sethkaz/SuperPower-GPLv3/README.md

# Super Power RPi Project

This repo was created to make a copy of the SuperPower-RPi project under the license GPLv3.

Please refer to the main Repo (https://github.com/SensorsIot/SuperPower) for the latest version.
