sethkaz/SuperPower-GPLv3/SuperPower-RPi-KiCAD/SuperPower-RPi-KiCAD.kicad_pcb

## KiCad design SuperPower-RPi-KiCAD/SuperPower-RPi-KiCAD.kicad_pcb (2021-02-07)

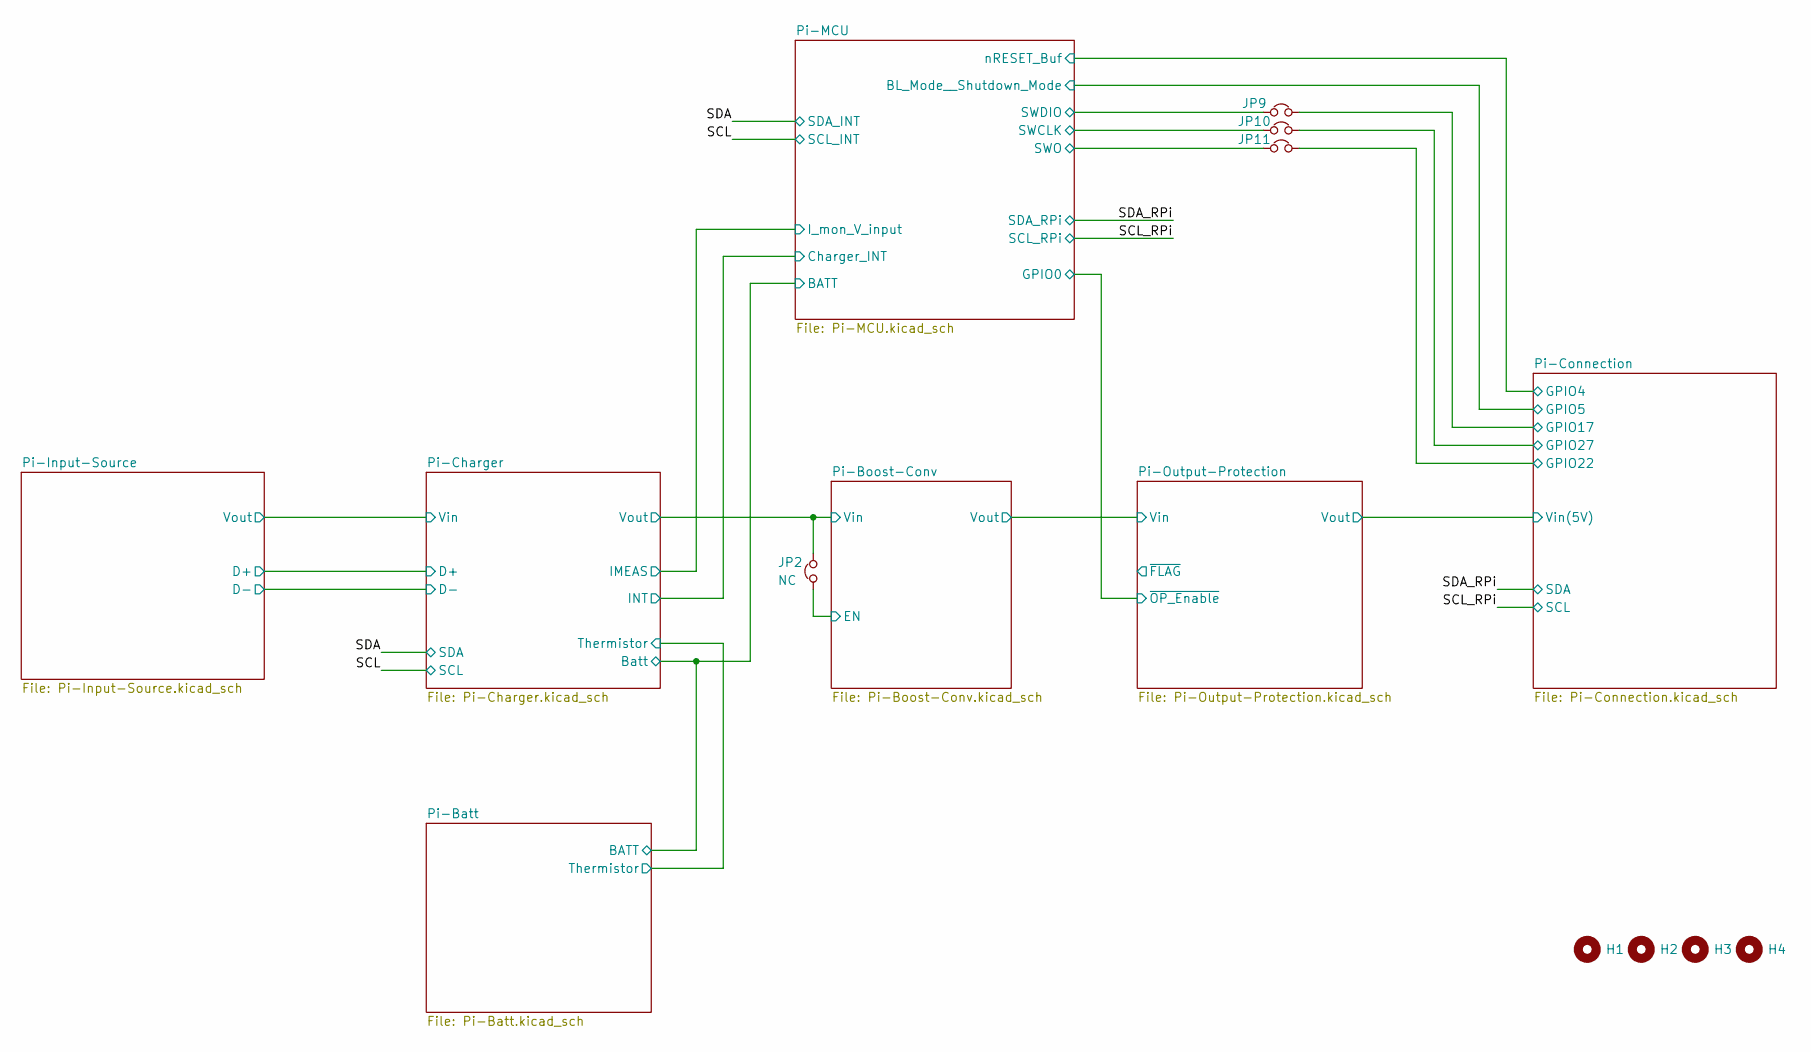
[picture p1: schematic SuperPower-RPi-KiCAD.kicad_sch, SuperPower-Leto]

Parts:
H1, H2, H3, H4: DNP; MountingHole_2.7mm_M2.5_ISO14580_Pad_TopBottom
JP2: NC; SolderJumper-2_P1.3mm_Bridged_Pad1.0x1.5mm
JP9, JP10, JP11: Jumper_NC_Small; SolderJumper-2_P1.3mm_Bridged_Pad1.0x1.5mm

Connections:
/Pi-Boost-Conv/EN: JP2.1; also elsewhere on the board
/Pi-Boost-Conv/Vin: JP2.2; also elsewhere on the board
/Pi-Connection/GPIO17: JP9.2; also elsewhere on the board
/Pi-Connection/GPIO22: JP11.2; also elsewhere on the board
/Pi-Connection/GPIO27: JP10.2; also elsewhere on the board
/Pi-MCU/SWCLK: JP10.1; also elsewhere on the board
/Pi-MCU/SWDIO: JP9.1; also elsewhere on the board
/Pi-MCU/SWO: JP11.1; also elsewhere on the board

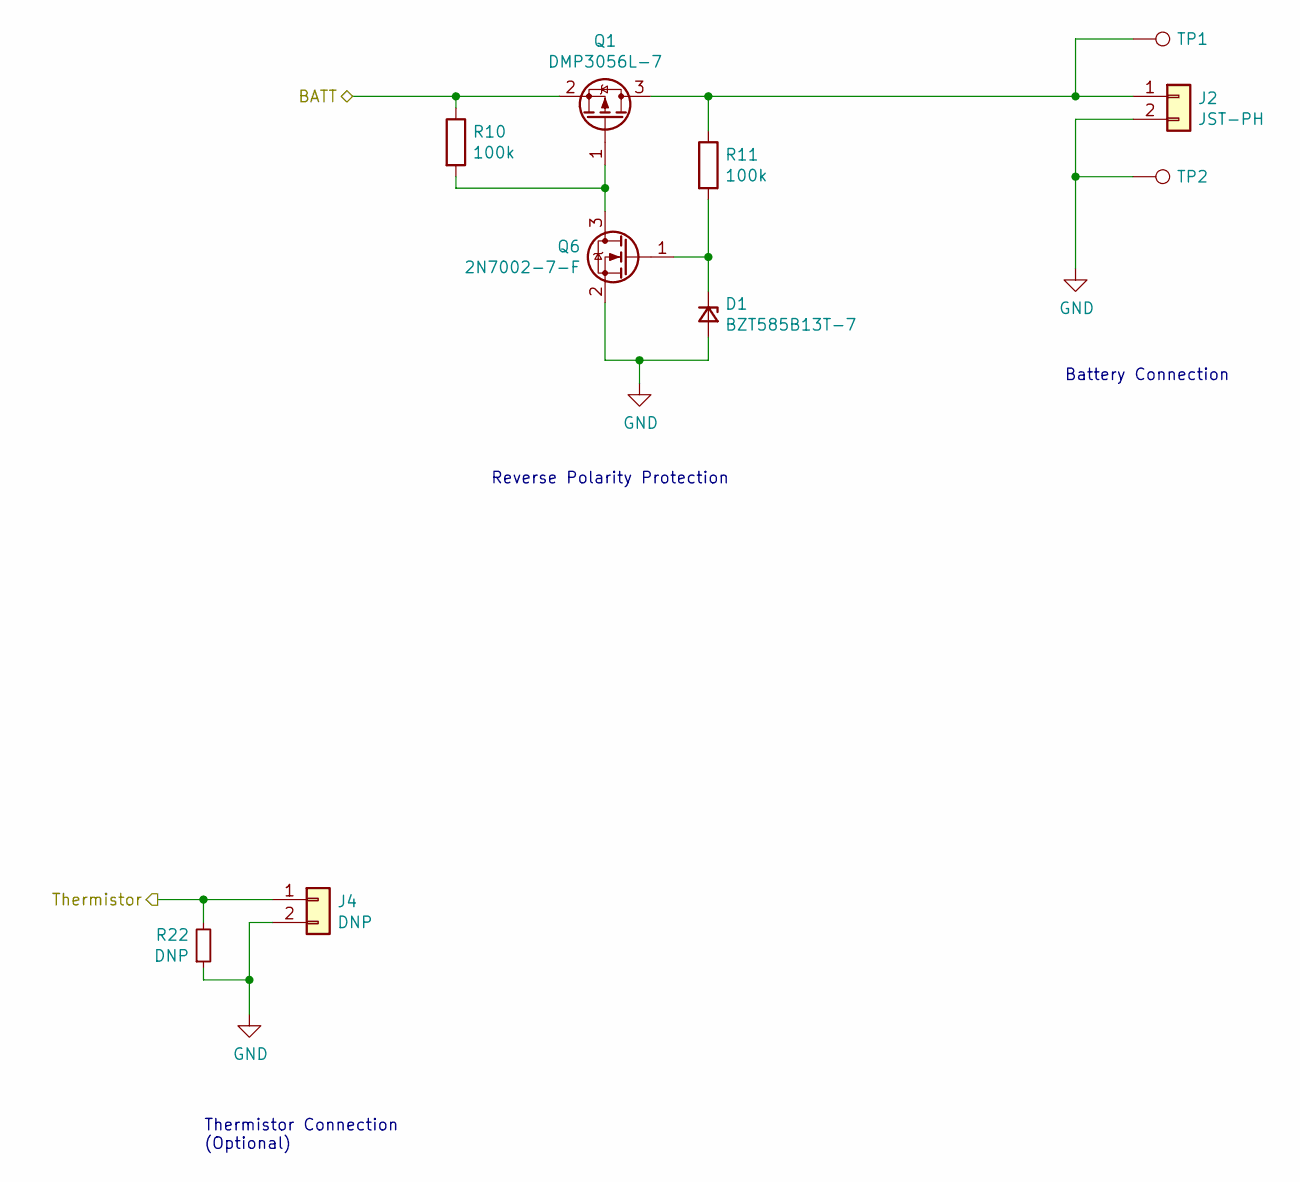
[picture p2: schematic Pi-Batt.kicad_sch, SuperPower-Leto]

Parts:
D1: BZT585B13T-7; D_SOD-523; Mfg PN BZT585B13T-7; Digi-Key PN BZT585B13T-7DICT-ND
J2: JST-PH; JST_PH_S2B-PH-K_1x02_P2.00mm_Horizontal; Mfg PN S2B-PH-K-S(LF)(SN)
J4: DNP; PinHeader_1x02_P2.00mm_Vertical; Mfg PN DNP
Q1: Q_PMOS_DMP3056L-7_SOT-23; SOT-23; Mfg PN DMP3056L-7; Digi-Key PN DMP3056L-7DICT-ND
Q6: 2N7002-7-F; SOT-23; Mfg PN 2N7002-7-F; Digi-Key PN 2N7002-FDICT-ND
R10, R11: 100k; R_0402_1005Metric; Mfg PN RC0402FR-07100KL; Digi-Key PN 311-100KLRCT-ND
R22: DNP; R_0603_1608Metric
TP1, TP2: DNP; SolderWire-1.5sqmm_1x01_D1.7mm_OD3.9mm

Connections:
/Pi-Batt/BATT: Q1.2 (S), R10.1; also elsewhere on the board
/Pi-Batt/Thermistor: J4.1, R22.2; also elsewhere on the board
GND: D1.2 (A), J2.2, J4.2, Q6.2 (S), R22.1, TP2.1; also elsewhere on the board
unnamed: D1.1 (K), Q6.1 (G), R11.2
unnamed: J2.1, Q1.3 (D), R11.1, TP1.1
unnamed: Q1.1 (G), Q6.3 (D), R10.2

Notes on the sheet:
Thermistor Connection (Optional)
Reverse Polarity Protection
Battery Connection

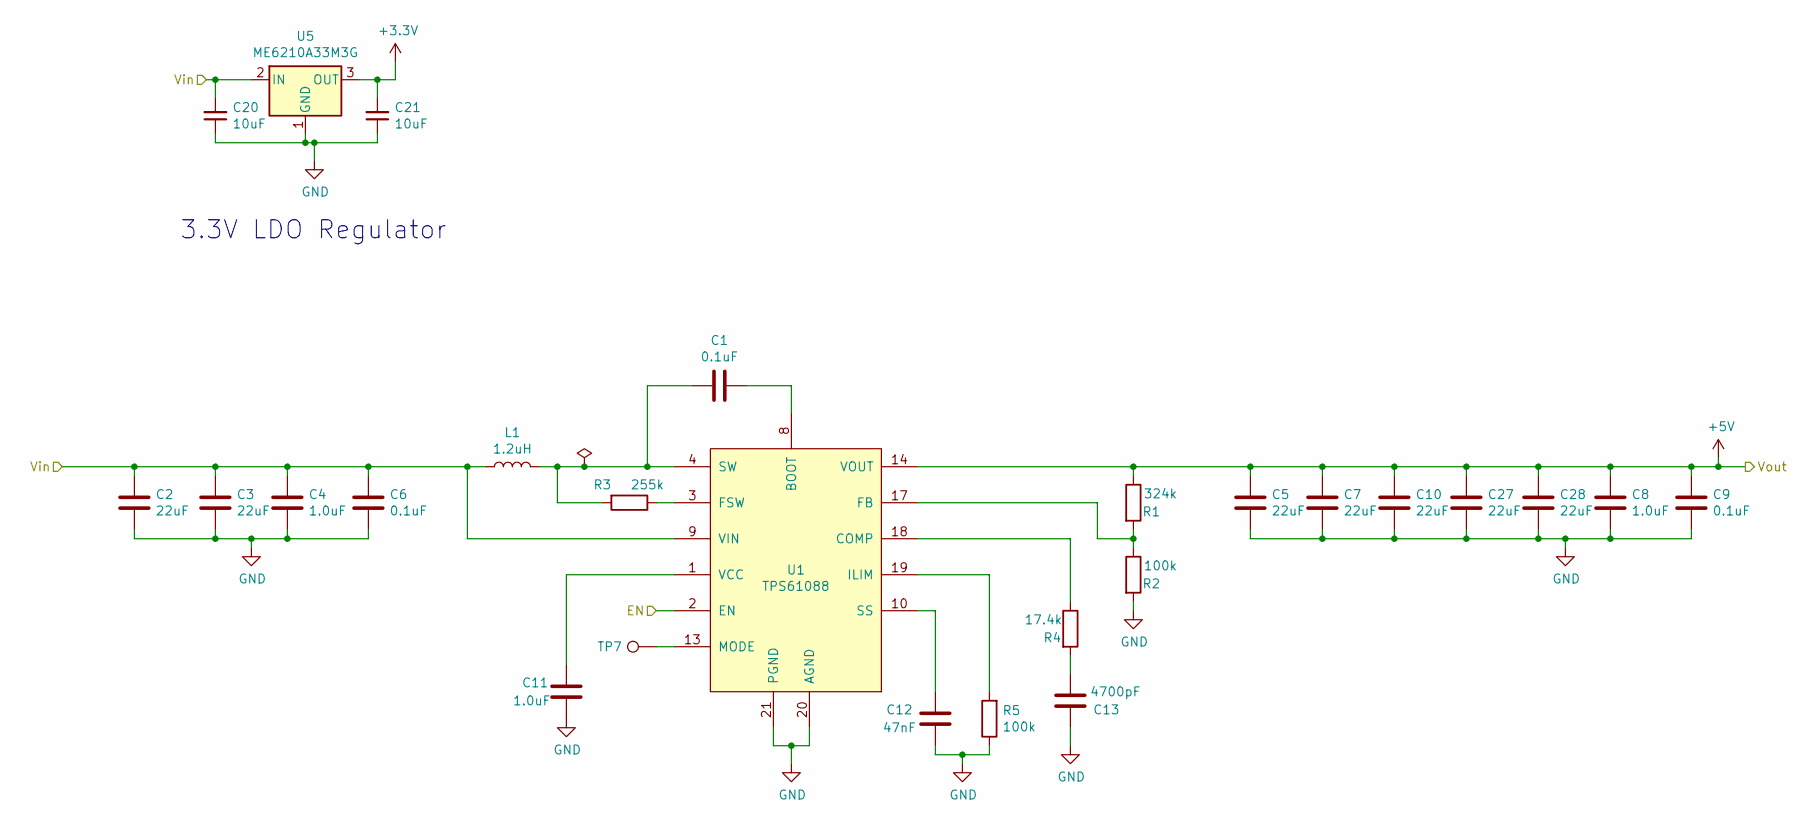
[picture p3: schematic Pi-Boost-Conv.kicad_sch, SuperPower-Leto]

Parts:
C1, C6, C9: 0.1uF; C_0402_1005Metric; Mfg PN TMK105BJ104KV-F; Digi-Key PN 587-1456-1-ND
C2, C3, C5, C7, C10, C27, C28: 22uF; C_1206_3216Metric; Mfg PN CL31A226KAHNNNE; Digi-Key PN 1276-3047-1-ND
C4, C8, C11: 1.0uF; C_0402_1005Metric; Mfg PN GRM155R61E105KA12D; Digi-Key PN 490-10017-1-ND
C12: 47nF; C_0402_1005Metric; Mfg PN GRM155R71E473KA88D; Digi-Key PN 490-3254-1-ND
C13: 4700pF; C_0402_1005Metric; Mfg PN CC0402KRX7R8BB472; Digi-Key PN 311-1039-1-ND
C20, C21: 10uF; C_0805_2012Metric; Mfg PN GRM21BR61E106KA73L; Digi-Key PN 490-5523-1-ND
L1: 1.2uH; L_Sumida_CDMC8D28_9.5x8.7mm; Mfg PN CDMC8D28NP-1R2MC; Digi-Key PN 308-1618-1-ND
R1: 324k; R_0402_1005Metric; Mfg PN ERJ-2RKF3243X; Digi-Key PN P324KLCT-ND
R2: 100k; R_0402_1005Metric; Mfg PN RC0402FR-07100KL; Digi-Key PN 311-100KLRCT-ND
R3: 255k; R_0603_1608Metric; Mfg PN RC0603FR-07255KL; Digi-Key PN 311-255KHRCT-ND
R4: 17.4k; R_0402_1005Metric; Mfg PN RC0402FR-0717K4L; Digi-Key PN 311-17.4KLRCT-ND
R5: 100k; R_0603_1608Metric; Mfg PN RC0603FR-07100KL; Digi-Key PN 311-100KHRCT-ND
TP7: DNP; TestPoint_Pad_1.0x1.0mm
U1: TPS61088; TI_VQFN_3.5x4.5mm; Mfg PN TPS61088RHLR; Digi-Key PN 296-43620-1-ND
U5: ME6210A33M3G; SOT-23; Mfg PN ME6210A33M3G

Connections:
+3V3: C21.2, U5.3 (OUT); also elsewhere on the board
+5V: C5.1, C7.1, C8.1, C9.1, C10.1, C27.1, C28.1, R1.1, U1.14 (VOUT), U1.15 (VOUT), U1.16 (VOUT); also elsewhere on the board
/Pi-Boost-Conv/EN: U1.2 (EN); also elsewhere on the board
/Pi-Boost-Conv/Vin: C2.1, C3.1, C4.1, C6.1, C20.2, L1.1, U1.9 (VIN), U5.2 (IN); also elsewhere on the board
GND: C2.2, C3.2, C4.2, C5.2, C6.2, C7.2, C8.2, C9.2, C10.2, C11.2, C12.1, C13.2, C20.1, C21.1, C27.2, C28.2, R2.2, R5.1, U1.11 (NC), U1.12 (NC), U1.20 (AGND), U1.21 (PGND), U5.1 (GND); also elsewhere on the board
unnamed: C1.1, U1.8 (BOOT)
unnamed: C1.2, L1.2, R3.2, U1.4 (SW), U1.5 (SW), U1.6 (SW), U1.7 (SW)
unnamed: C11.1, U1.1 (VCC)
unnamed: C12.2, U1.10 (SS)
unnamed: C13.1, R4.2
unnamed: R1.2, R2.1, U1.17 (FB)
unnamed: R3.1, U1.3 (FSW)
unnamed: R4.1, U1.18 (COMP)
unnamed: R5.2, U1.19 (ILIM)
unnamed: TP7.1, U1.13 (MODE)

Notes on the sheet:
3.3V LDO Regulator

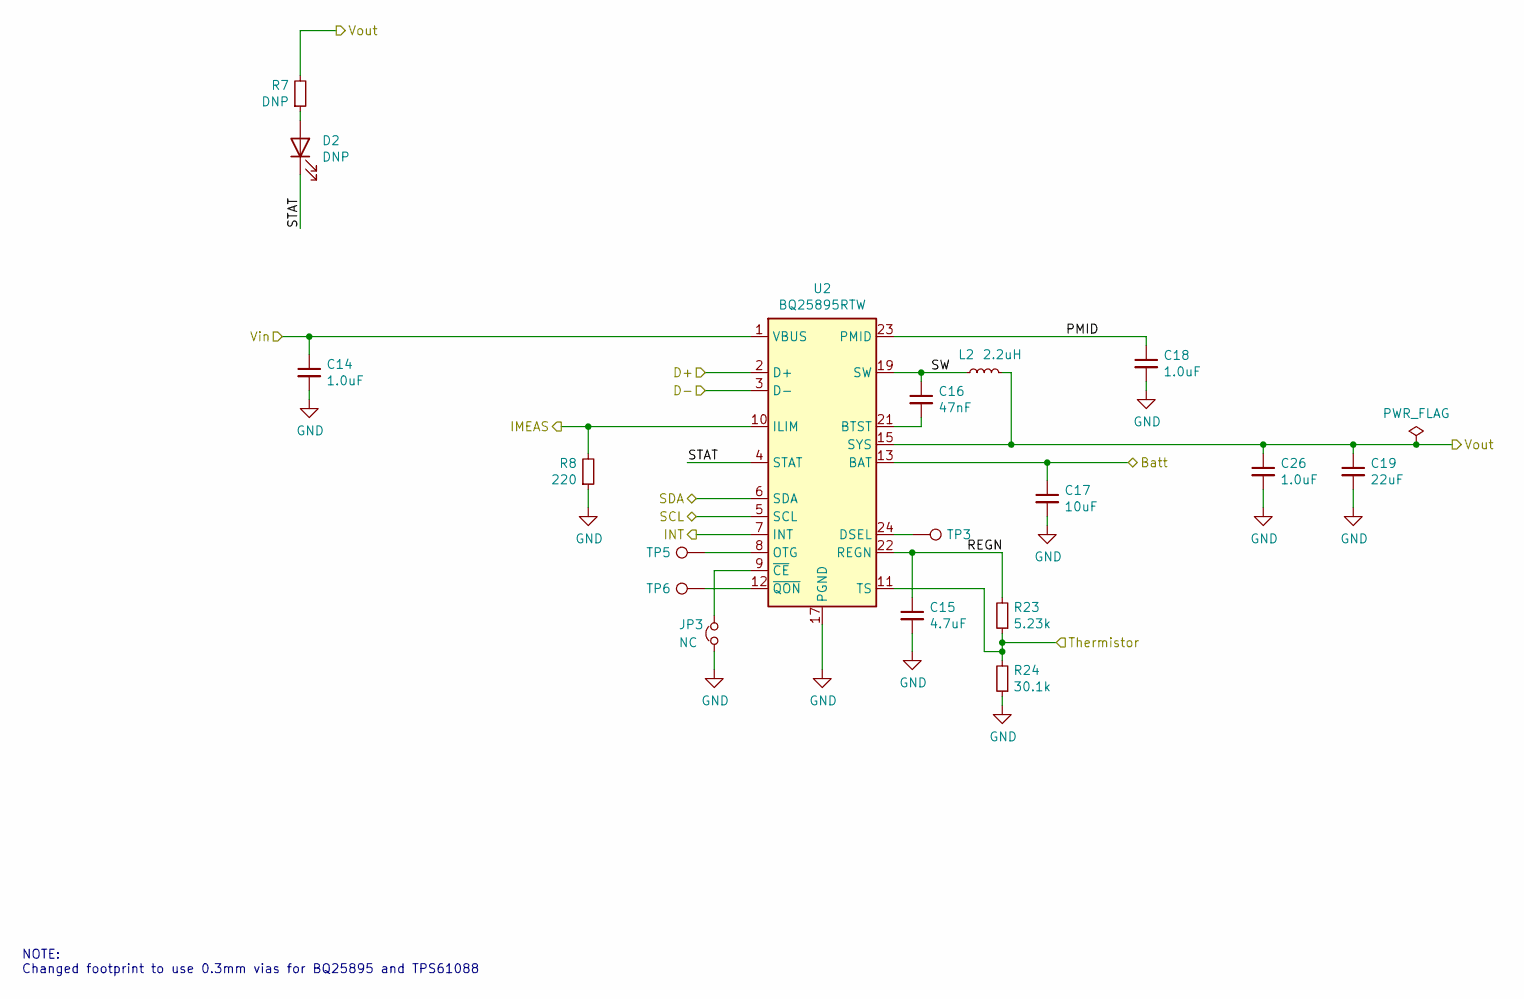
[picture p4: schematic Pi-Charger.kicad_sch, SuperPower-Leto]

Parts:
C14, C18, C26: 1.0uF; C_0402_1005Metric; Mfg PN GRM155R61E105KA12D; Digi-Key PN 490-10017-1-ND
C15: 4.7uF; C_0603_1608Metric; Mfg PN CL10A475KA8NQNC; Digi-Key PN 1276-1900-1-ND
C16: 47nF; C_0402_1005Metric; Mfg PN GRM155R71E473KA88D; Digi-Key PN 490-3254-1-ND
C17: 10uF; C_0805_2012Metric; Mfg PN GRM21BR61E106KA73L; Digi-Key PN 490-5523-1-ND
C19: 22uF; C_1206_3216Metric; Mfg PN CL31A226KAHNNNE; Digi-Key PN 1276-3047-1-ND
D2: DNP; LED_0603_1608Metric
JP3: NC; SolderJumper-2_P1.3mm_Bridged_Pad1.0x1.5mm
L2: 2.2uH; L_Vishay_IHLP-2525; Mfg PN IHLP2525CZER2R2M01; Digi-Key PN 541-1008-1-ND
R7: DNP; R_0603_1608Metric
R8: 220; R_0603_1608Metric; Mfg PN RC0603FR-07220RL; Digi-Key PN 311-220HRCT-ND
R23: 5.23k; R_0603_1608Metric; Mfg PN RC0603FR-075K23L; Digi-Key PN 311-5.23KHRCT-ND
R24: 30.1k; R_0603_1608Metric; Mfg PN RC0603FR-0730K1L; Digi-Key PN 311-30.1KHRCT-ND
TP3, TP5, TP6: DNP; TestPoint_Pad_1.0x1.0mm
U2: BQ25895RTW; Texas_S-PWQFN-N24_EP2.7x2.7mm_ThermalVias; Mfg PN BQ25895RTWR; Digi-Key PN 296-44345-1-ND

Connections:
/Pi-Batt/BATT: C17.1, U2.13 (BAT), U2.14 (BAT); also elsewhere on the board
/Pi-Batt/Thermistor: R23.1, R24.2, U2.11 (TS); also elsewhere on the board
/Pi-Boost-Conv/Vin: C19.1, C26.1, L2.2, R7.2, U2.15 (SYS), U2.16 (SYS); also elsewhere on the board
/Pi-Charger/D+: U2.2 (D+); also elsewhere on the board
/Pi-Charger/D-: U2.3 (D-); also elsewhere on the board
/Pi-Charger/IMEAS: R8.2, U2.10 (ILIM); also elsewhere on the board
/Pi-Charger/PMID: C18.1, U2.23 (PMID)
/Pi-Charger/REGN: C15.1, R23.2, U2.22 (REGN)
/Pi-Charger/STAT: D2.1 (K), U2.4 (STAT)
/Pi-Charger/SW: C16.1, L2.1, U2.19 (SW), U2.20 (SW)
/Pi-Charger/Vin: C14.1, U2.1 (VBUS); also elsewhere on the board
/Pi-MCU/Charger_INT: U2.7 (INT); also elsewhere on the board
/SCL: U2.5 (SCL); also elsewhere on the board
/SDA: U2.6 (SDA); also elsewhere on the board
GND: C14.2, C15.2, C17.2, C18.2, C19.2, C26.2, JP3.1, R8.1, R24.1, U2.17 (PGND), U2.18 (PGND), U2.25 (PGND); also elsewhere on the board
unnamed: C16.2, U2.21 (BTST)
unnamed: D2.2 (A), R7.1
unnamed: JP3.2, U2.9 (~CE)
unnamed: TP3.1, U2.24 (DSEL)
unnamed: TP5.1, U2.8 (OTG)
unnamed: TP6.1, U2.12 (~QON)

Notes on the sheet:
NOTE: Changed footprint to use 0.3mm vias for BQ25895 and TPS61088

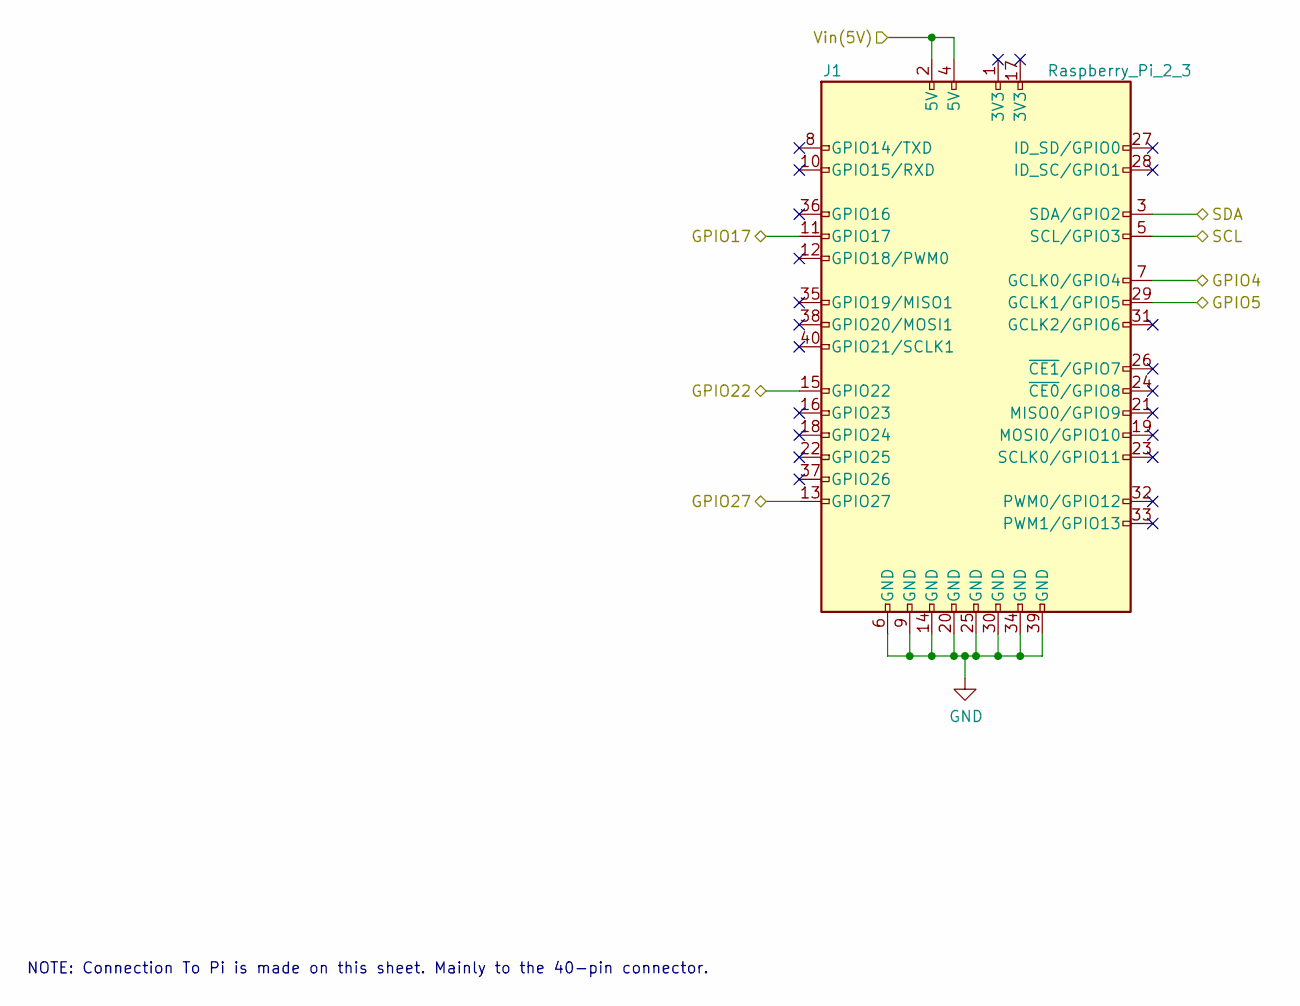
[picture p5: schematic Pi-Connection.kicad_sch, SuperPower-Leto]

Parts:
J1: Raspberry_Pi_2_3; PinSocket_2x20_P2.54mm_Vertical_With_Pogo

Connections:
/Pi-Connection/GPIO4: J1.7 (GCLK0/GPIO4); also elsewhere on the board
/Pi-Connection/GPIO17: J1.11 (GPIO17); also elsewhere on the board
/Pi-Connection/GPIO22: J1.15 (GPIO22); also elsewhere on the board
/Pi-Connection/GPIO27: J1.13 (GPIO27); also elsewhere on the board
/Pi-Connection/Vin(5V): J1.2 (5V), J1.4 (5V); also elsewhere on the board
/Pi-MCU/BL_Mode__Shutdown_Mode: J1.29 (GCLK1/GPIO5); also elsewhere on the board
/SCL_RPi: J1.5 (SCL/GPIO3); also elsewhere on the board
/SDA_RPi: J1.3 (SDA/GPIO2); also elsewhere on the board
GND: J1.6 (GND), J1.9 (GND), J1.14 (GND), J1.20 (GND), J1.25 (GND), J1.30 (GND), J1.34 (GND), J1.39 (GND); also elsewhere on the board

Notes on the sheet:
NOTE: Connection To Pi is made on this sheet. Mainly to the 40-pin connector.

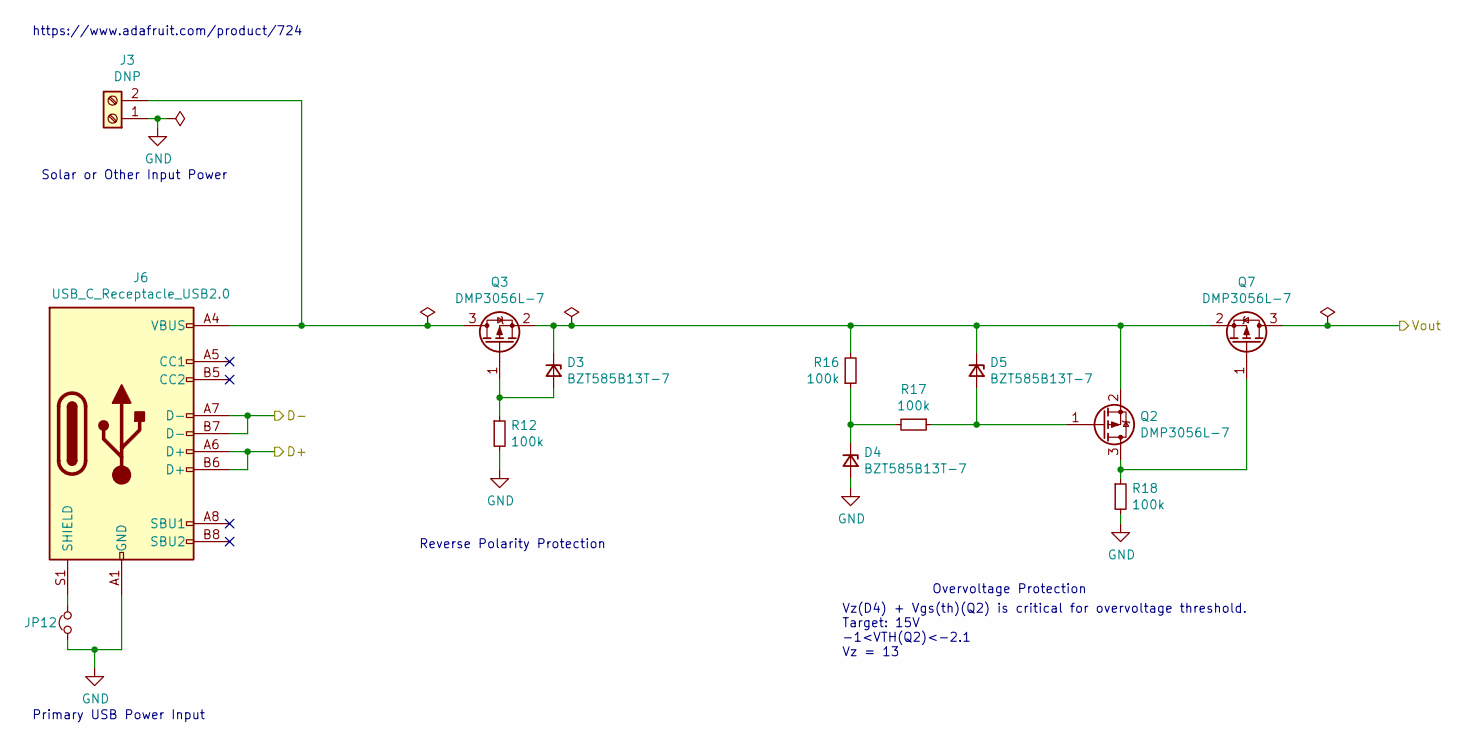
[picture p6: schematic Pi-Input-Source.kicad_sch, SuperPower-Leto]

Parts:
D3, D4, D5: BZT585B13T-7; D_SOD-523; Mfg PN BZT585B13T-7; Digi-Key PN BZT585B13T-7DICT-ND
J3: DNP; TerminalBlock_4Ucon_1x02_P3.50mm_Horizontal; Mfg PN 724
J6: USB_C_Receptacle_USB2.0; USB_C_Receptacle_HRO_TYPE-C-31-M-12; Mfg PN TYPE-C-31-M-12
JP12: Jumper_NC_Small; SolderJumper-2_P1.3mm_Bridged_Pad1.0x1.5mm
Q2, Q3, Q7: Q_PMOS_DMP3056L-7_SOT-23; SOT-23; Mfg PN DMP3056L-7; Digi-Key PN DMP3056L-7DICT-ND
R12, R16, R17, R18: 100k; R_0402_1005Metric; Mfg PN RC0402FR-07100KL; Digi-Key PN 311-100KLRCT-ND

Connections:
/Pi-Charger/D+: J6.A6 (D+), J6.B6 (D+); also elsewhere on the board
/Pi-Charger/D-: J6.A7 (D-), J6.B7 (D-); also elsewhere on the board
/Pi-Charger/Vin: Q7.3 (D); also elsewhere on the board
GND: D4.2 (A), J3.1, J6.A1 (GND), J6.A12 (GND), J6.B1 (GND), J6.B12 (GND), JP12.1, R12.2, R18.2; also elsewhere on the board
unnamed: D3.1 (K), D5.1 (K), Q2.2 (S), Q3.2 (S), Q7.2 (S), R16.2
unnamed: D3.2 (A), Q3.1 (G), R12.1
unnamed: D4.1 (K), R16.1, R17.2
unnamed: D5.2 (A), Q2.1 (G), R17.1
unnamed: J3.2, J6.A4 (VBUS), J6.A9 (VBUS), J6.B4 (VBUS), J6.B9 (VBUS), Q3.3 (D)
unnamed: J6.S1 (SHIELD), JP12.2
unnamed: Q2.3 (D), Q7.1 (G), R18.1

Notes on the sheet:
https://www.adafruit.com/product/724
Primary USB Power Input
Solar or Other Input Power
Reverse Polarity Protection
Vz(D4) + Vgs(th)(Q2) is critical for overvoltage threshold. Target: 15V -1<VTH(Q2)<-2.1 Vz = 13
Overvoltage Protection

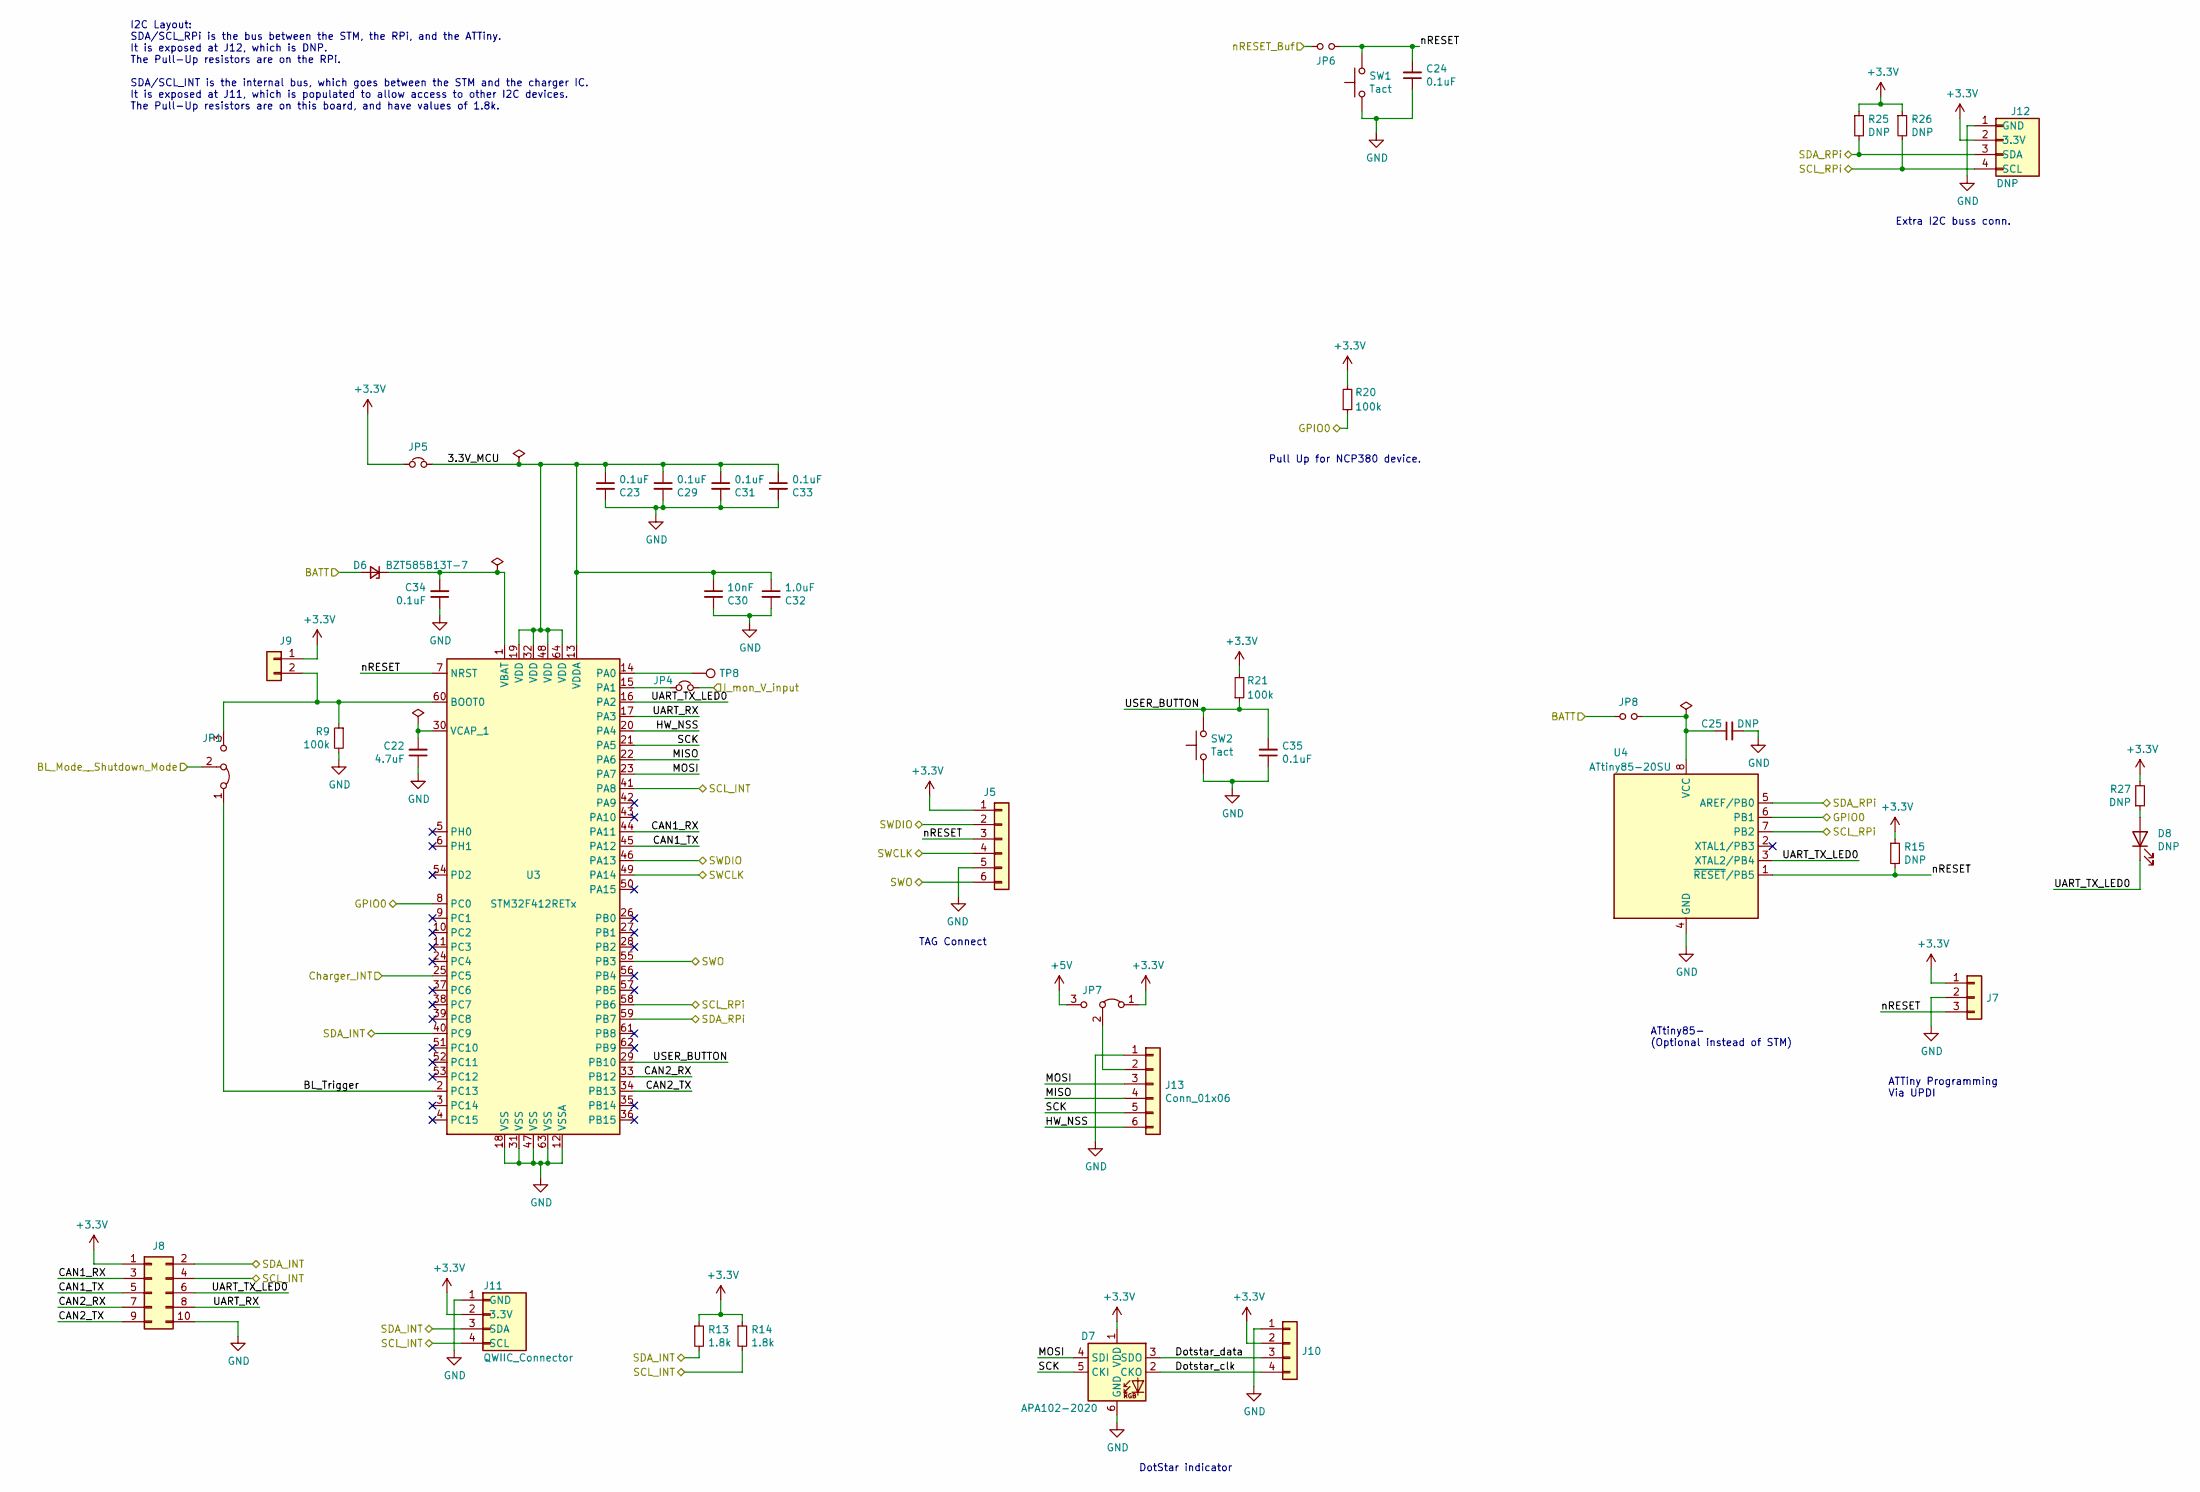
[picture p7: schematic Pi-MCU.kicad_sch, SuperPower-Leto]

Parts:
C22: 4.7uF; C_0603_1608Metric; Mfg PN CL10A475KA8NQNC; Digi-Key PN 1276-1900-1-ND
C23, C24, C29, C31, C33, C34, C35: 0.1uF; C_0402_1005Metric; Mfg PN TMK105BJ104KV-F; Digi-Key PN 587-1456-1-ND
C25: DNP; C_0603_1608Metric
C30: 10nF; C_0402_1005Metric; Mfg PN GCM155R71H103KA55D; Digi-Key PN 490-4762-1-ND
C32: 1.0uF; C_0402_1005Metric; Mfg PN GRM155R61E105KA12D; Digi-Key PN 490-10017-1-ND
D6: BZT585B13T-7; D_SOD-523; Mfg PN BZT585B13T-7; Digi-Key PN BZT585B13T-7DICT-ND
D7: APA102-2020; LED-APA102-2020
D8: DNP; LED_0603_1608Metric
J5: DNP; Tag-Connect_TC2030-IDC-NL_2x03_P1.27mm_Vertical; Mfg PN DNP
J7: Conn_01x03; PinHeader_1x03_P2.54mm_Vertical
J8: Conn_02x05_Odd_Even; PinHeader_2x05_P2.54mm_Vertical
J9: Conn_01x02; PinHeader_1x02_P2.54mm_Vertical
J10: Conn_01x04; PinHeader_1x04_P2.54mm_Vertical
J11: QWIIC_Connector; JST_SH_SM04B-SRSS-TB_1x04-1MP_P1.00mm_Horizontal; Mfg PN SM04B-SRSS-TB(LF)(SN); Digi-Key PN 455-1804-1-ND
J12: DNP; JST_SH_SM04B-SRSS-TB_1x04-1MP_P1.00mm_Horizontal; Mfg PN SM04B-SRSS-TB(LF)(SN); Digi-Key PN 455-1804-1-ND
J13: Conn_01x06; PinHeader_1x06_P2.54mm_Vertical
JP1, JP7: DNP; SolderJumper-3_P1.3mm_Bridged12_RoundedPad1.0x1.5mm_NumberL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
JP4: NC; SolderJumper-2_P1.3mm_Bridged_Pad1.0x1.5mm
JP5: Jumper_NC_Small; PinHeader_1x02_P2.54mm_Vertical_Shorted
JP6, JP8: Jumper_NO_Small; SolderJumper-2_P1.3mm_Open_Pad1.0x1.5mm
R9, R20, R21: 100k; R_0402_1005Metric; Mfg PN RC0402FR-07100KL; Digi-Key PN 311-100KLRCT-ND
R13, R14: 1.8k; R_0603_1608Metric; Mfg PN RC0603FR-071K8L; Digi-Key PN 311-1.80KHRCT-ND
R15, R25, R26, R27: DNP; R_0603_1608Metric
SW1, SW2: Tact; SW_Push_1P1T-SH_NO_CK_KMR2xxG; Mfg PN KMR221GLFS; Digi-Key PN 401-1427-1-ND
TP8: DNP; TestPoint_Pad_1.0x1.0mm
U3: STM32F412RETx; LQFP-64_10x10mm_P0.5mm; Mfg PN STM32F412RET6; Digi-Key PN 497-19350-1-ND
U4: ATtiny85-20SU; SOIJ-8_5.3x5.3mm_P1.27mm

Connections:
+3V3: D7.1 (VDD), J5.1, J7.1, J8.1, J9.1, J10.2, J11.2 (3.3V), J12.2 (3.3V), JP5.1, JP7.1 (A), R13.1, R14.1, R15.1, R20.2, R21.2, R25.1, R26.1, R27.2; also elsewhere on the board
+5V: JP7.3 (B); also elsewhere on the board
/Pi-Batt/BATT: D6.2 (A), JP8.2; also elsewhere on the board
/Pi-Charger/IMEAS: JP4.2; also elsewhere on the board
/Pi-Connection/GPIO4: JP6.1; also elsewhere on the board
/Pi-MCU/3.3V_MCU: C23.1, C29.1, C30.1, C31.1, C32.1, C33.1, JP5.2, U3.13 (VDDA), U3.19 (VDD), U3.32 (VDD), U3.48 (VDD), U3.64 (VDD)
/Pi-MCU/BL_Mode__Shutdown_Mode: JP1.2 (C); also elsewhere on the board
/Pi-MCU/BL_Trigger: JP1.1 (A), U3.2 (PC13)
/Pi-MCU/CAN1_RX: J8.3, U3.44 (PA11)
/Pi-MCU/CAN1_TX: J8.5, U3.45 (PA12)
/Pi-MCU/CAN2_RX: J8.7, U3.33 (PB12)
/Pi-MCU/CAN2_TX: J8.9, U3.34 (PB13)
/Pi-MCU/Charger_INT: U3.25 (PC5); also elsewhere on the board
/Pi-MCU/Dotstar_clk: D7.2 (CKO), J10.4
/Pi-MCU/Dotstar_data: D7.3 (SDO), J10.3
/Pi-MCU/GPIO0: R20.1, U3.8 (PC0), U4.6 (PB1); also elsewhere on the board
/Pi-MCU/HW_NSS: J13.6, U3.20 (PA4)
/Pi-MCU/MISO: J13.4, U3.22 (PA6)
/Pi-MCU/MOSI: D7.4 (SDI), J13.3, U3.23 (PA7)
/Pi-MCU/SCK: D7.5 (CKI), J13.5, U3.21 (PA5)
/Pi-MCU/SWCLK: J5.4, U3.49 (PA14); also elsewhere on the board
/Pi-MCU/SWDIO: J5.2, U3.46 (PA13); also elsewhere on the board
/Pi-MCU/SWO: J5.6, U3.55 (PB3); also elsewhere on the board
/Pi-MCU/UART_RX: J8.8, U3.17 (PA3)
/Pi-MCU/UART_TX_LED0: D8.1 (K), J8.6, U3.16 (PA2), U4.3 (XTAL2/PB4)
/Pi-MCU/USER_BUTTON: C35.2, R21.1, SW2.2, U3.29 (PB10)
/Pi-MCU/nRESET: C24.2, J5.3, J7.3, JP6.2, R15.2, SW1.2, U3.7 (NRST), U4.1 (~RESET~/PB5)
/SCL: J8.4, J11.4 (SCL), R14.2, U3.41 (PA8); also elsewhere on the board
/SCL_RPi: J12.4 (SCL), R26.2, U3.58 (PB6), U4.7 (PB2); also elsewhere on the board
/SDA: J8.2, J11.3 (SDA), R13.2, U3.40 (PC9); also elsewhere on the board
/SDA_RPi: J12.3 (SDA), R25.2, U3.59 (PB7), U4.5 (AREF/PB0); also elsewhere on the board
GND: C22.1, C23.2, C24.1, C25.2, C29.2, C30.2, C31.2, C32.2, C33.2, C34.1, C35.1, D7.6 (GND), J5.5, J7.2, J8.10, J10.1, J11.1 (GND), J12.1 (GND), J13.1, R9.2, SW1.1, SW2.1, U3.12 (VSSA), U3.18 (VSS), U3.31 (VSS), U3.47 (VSS), U3.63 (VSS), U4.4 (GND); also elsewhere on the board
unnamed: C22.2, U3.30 (VCAP_1)
unnamed: C25.1, JP8.1, U4.8 (VCC)
unnamed: C34.2, D6.1 (K), U3.1 (VBAT)
unnamed: D8.2 (A), R27.1
unnamed: J9.2, JP1.3 (B), R9.1, U3.60 (BOOT0)
unnamed: J13.2, JP7.2 (C)
unnamed: JP4.1, U3.15 (PA1)
unnamed: TP8.1, U3.14 (PA0)

Notes on the sheet:
I2C Layout: SDA/SCL_RPi is the bus between the STM, the RPi, and the ATTiny. It is exposed at J12, which is DNP. The Pull-Up resistors are on the RPi. SDA/SCL_INT is the internal bus, which goes between the STM and the charger IC. It is exposed at J11, which is populated to allow access to other I2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
TAG Connect
DotStar indicator
Pull Up for NCP380 device.
ATtiny85- (Optional instead of STM)
ATTiny Programming Via UPDI
Extra I2C buss conn.

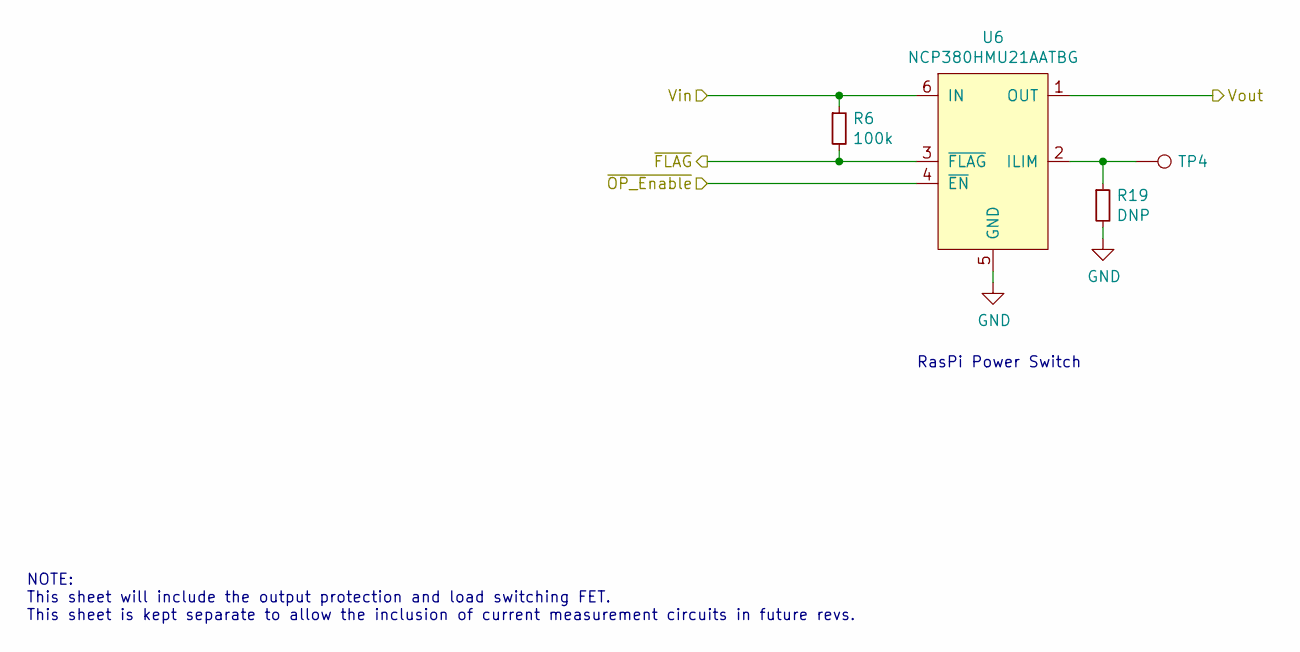
[picture p8: schematic Pi-Output-Protection.kicad_sch, SuperPower-Leto]

Parts:
R6: 100k; R_0402_1005Metric; Mfg PN RC0402FR-07100KL; Digi-Key PN 311-100KLRCT-ND
R19: DNP; R_0603_1608Metric; Mfg PN DNP; Digi-Key PN DNP
TP4: DNP; TestPoint_Pad_1.0x1.0mm
U6: NCP380HMU21AATBG; UDFN-6-1EP_2x2mm_P0.65mm_EP0.95x1.7mm; Mfg PN NCP380HMU21AATBG; Digi-Key PN NCP380HMU21AATBGOSCT-ND

Connections:
+5V: R6.1, U6.6 (IN); also elsewhere on the board
/Pi-Connection/Vin(5V): U6.1 (OUT); also elsewhere on the board
/Pi-MCU/GPIO0: U6.4 (~EN); also elsewhere on the board
/Pi-Output-Protection/~FLAG: R6.2, U6.3 (~FLAG)
GND: R19.2, U6.5 (GND), U6.7 (PAD); also elsewhere on the board
unnamed: R19.1, TP4.1, U6.2 (ILIM)

Notes on the sheet:
NOTE: This sheet will include the output protection and load switching FET. This sheet is kept separate to allow the inclusion of current measurement circuits in future revs.
RasPi Power Switch
