sethkaz/SuperPower-GPLv3/SuperPower-RPi-KiCAD/SuperPower-RPi-KiCAD.kicad_pcb

## KiCad design SuperPower-RPi-KiCAD/SuperPower-RPi-KiCAD.kicad_pcb (continued)

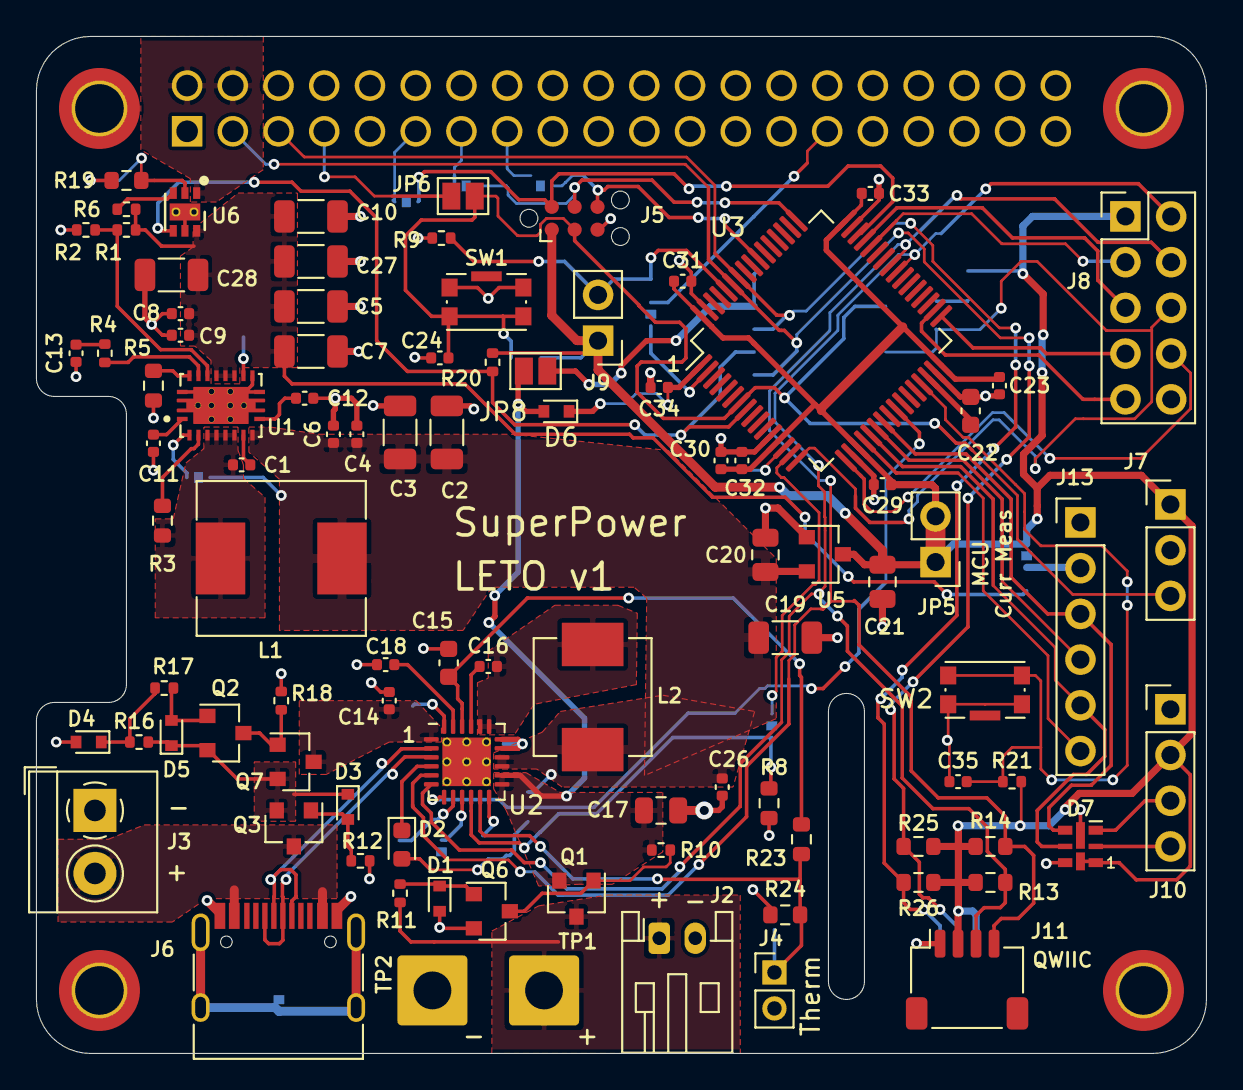
[picture p9: board SuperPower-RPi-KiCAD.kicad_pcb from above]

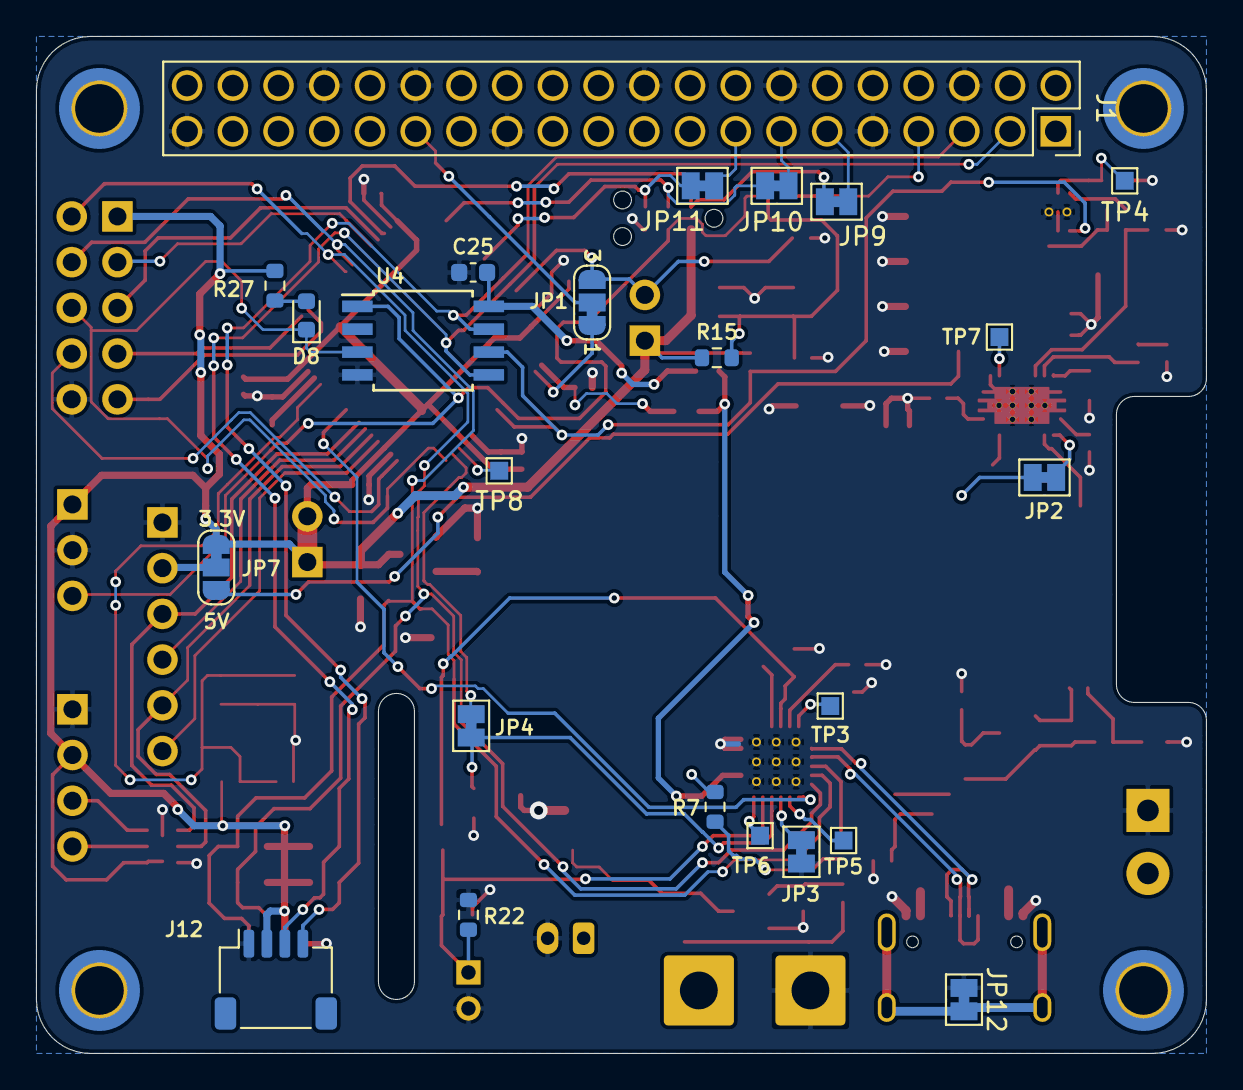
[picture p10: board SuperPower-RPi-KiCAD.kicad_pcb from below]

Board: 2 copper layers, 65.0 x 56.5 mm, 122 parts (24 on the bottom side), 82 nets.
