sethkaz/SuperPower-GPLv3/(commit log)

2021-01-24 Added snapshot of project under GPLv3
    [Pi-Batt.sch, Pi-Boost-Conv.sch, Pi-Charger.sch, Pi-Connection.sch, Pi-Input-Source.sch, Pi-MCU.sch, Pi-Output-Protection.sch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]
2021-01-29 Final prep for distribution to KiCAD folks.
    [Pi-Batt.sch, Pi-Boost-Conv.sch, Pi-Charger.sch, Pi-Connection.sch, Pi-Input-Source.sch, Pi-MCU.sch, Pi-Output-Protection.sch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]
2021-02-07 Updated to KiCAD v5.99 (and undid the non-change)
    [Pi-Batt.kicad_sch, Pi-Batt.sch, Pi-Boost-Conv.kicad_sch, Pi-Boost-Conv.sch, Pi-Charger.kicad_sch, Pi-Charger.sch, Pi-Connection.kicad_sch, Pi-Connection.sch]
